magmalag/Rod-Custom-55mm-ITB-Telemetry/RU.README.md

# VRod-Custom-55.5mm-ITB-Telemetry
Deep modernization, custom 55mm throttle bodies, asymmetric intake calculation, and Python/Arduino telemetry for H-D V-Rod
##  О проекте (About the Project)
Комплексный проект по глубокой модернизации впускной системы двигателя H-D Revolution (1250cc). Включает в себя механическую обработку (Custom Hardware), расчет газодинамики (Engine Simulation) и разработку программно-аппаратного комплекса для сбора и анализа телеметрии.

**Цель:** Переход со штатных 53 мм дросселей на 55 мм с сохранением стабильного холостого хода и максимизацией КПД на 9000 RPM.

---

##  Механика и Железо (Hardware & CAD)
Штатные оси и дроссельные заслонки не выдерживают нагрузок при увеличении диаметра. Узел был спроектирован с нуля:

* **Корпуса:** Расточены до 55 мм.
* **Оси (Split Shaft):** Кастомная составная ось из нержавеющей стали (8 мм). Фиксация винтов выполнена методом развальцовки стальным шариком (авиационный стандарт) для предотвращения обрыва от вибраций V-Twin.
* **Заслонки (Butterflies):** Выточены из твердой автоматной латуни (ЛС59-1, 1.5 мм). 
* **Геометрия:** Смоделирован эллипс под углом 4.5°. В CAD-системе рассчитан и устранен критический зазор в 23 микрона (0.023 мм) возле оси, что обеспечило 100% герметичность при закрытом дросселе (IAC control stabilized).






---

##  Газодинамика (Engine Analyzer Pro)
Двигатель V-Rod имеет разнодлинный выхлоп Rinehart 2-1 (Front 72 см / Rear 85 см). Для компенсации наполнения цилиндров (Volumetric Efficiency) была рассчитана асимметричная впускная система:

* **Front Stack:** 12.7 см — компенсирует короткий выхлоп, создает инерционный наддув на 6500-7000 RPM.
* **Rear Stack:** 9.5 см — позволяет цилиндру дышать на 8500-9000 RPM.

Моделирование доказало, что на 2250 RPM потоки (CFM) уравновешиваются, что позволило провести идеальную механическую синхронизацию ITB.



---

##  Софт и Телеметрия (Data Engineering & Tuning)
Для настройки нестандартного железа была использована система **Daytona Twin Tec (Alpha-N)**.

* **Data Logging:** Написаны скрипты на Python для парсинга, фильтрации аппаратного шума и агрегации сырых логов.
* **Синхронизация:** Анализ `MAP Delta` подтвердил идеальную механическую сборку (разница на холостом ходу составила всего 0.17 in-Hg).




---

##  Результат
Полностью рабочая, откалиброванная система, превосходящая заводские аналоги по надежности (нержавеющая сталь + ЛС59-1) и аэродинамике. Идеальный холостой ход и ровная полка мощности до 9500 RPM.



---
