magmalag/Rod-Custom-55mm-ITB-Telemetry/Images/IMG_20260406_121022.jpg

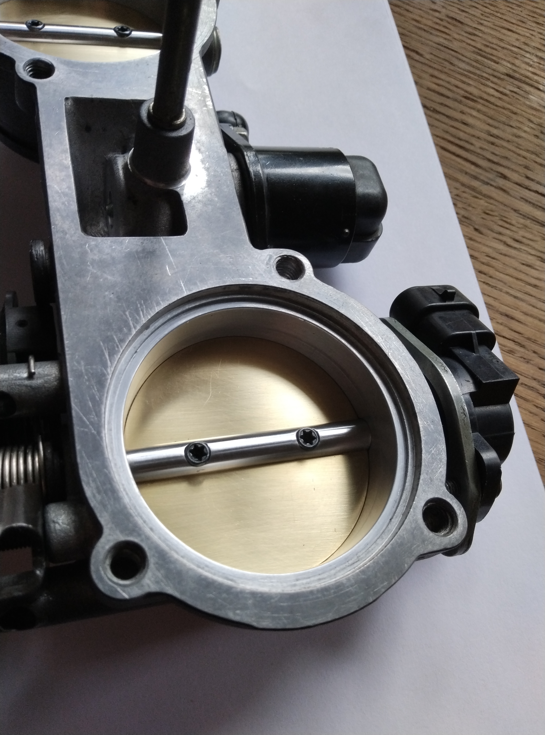
Images/IMG_20260406_121022.jpg
