magmalag/Rod-Custom-55mm-ITB-Telemetry/Images/IMG_20260425_112852.jpg

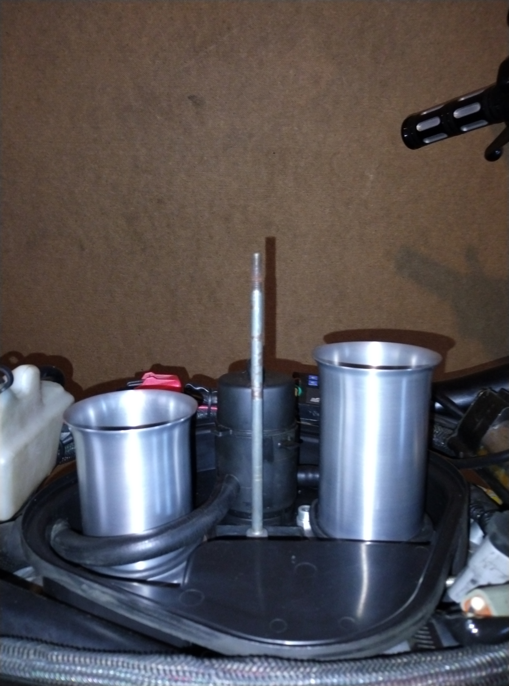
Images/IMG_20260425_112852.jpg
