magmalag/Rod-Custom-55mm-ITB-Telemetry/Images/IMG_20260425_112922.jpg

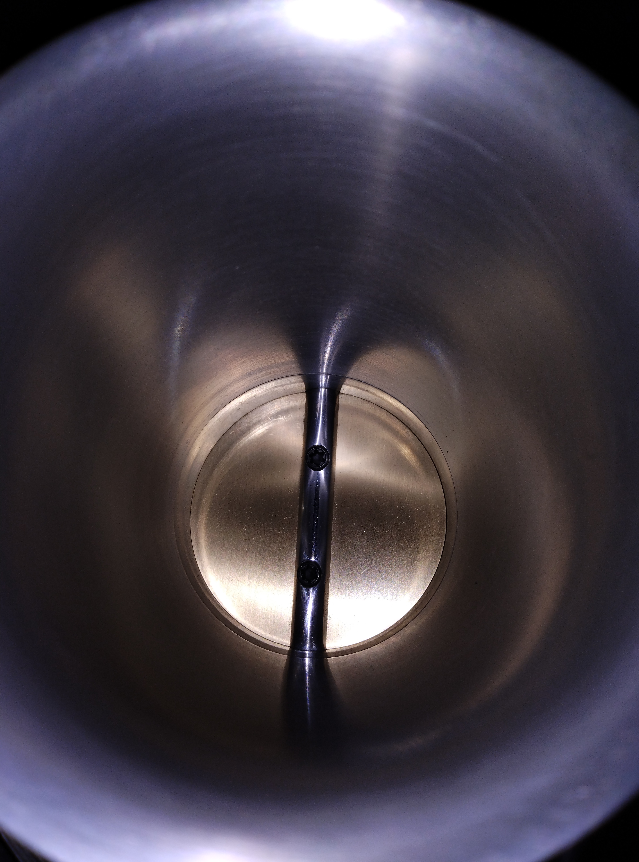
Images/IMG_20260425_112922.jpg
