magmalag/Rod-Custom-55mm-ITB-Telemetry/CAD_Model/Vrod throttle body 55.5mm.FCStd

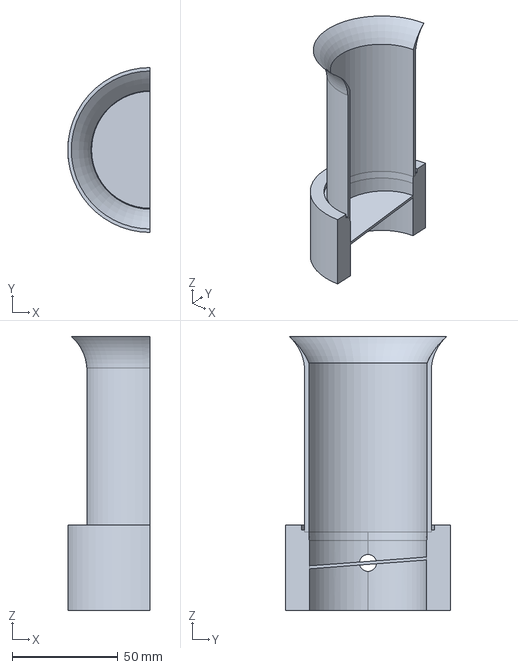
[picture p13: CAD file, 2026-04-25]
CAD_Model/Vrod throttle body 55.5mm.FCStd
39.0 x 78.0 x 129.5 mm
