magmalag/Rod-Custom-55mm-ITB-Telemetry/CAD_Model/Vrod throttle body base 53mm.FCStd

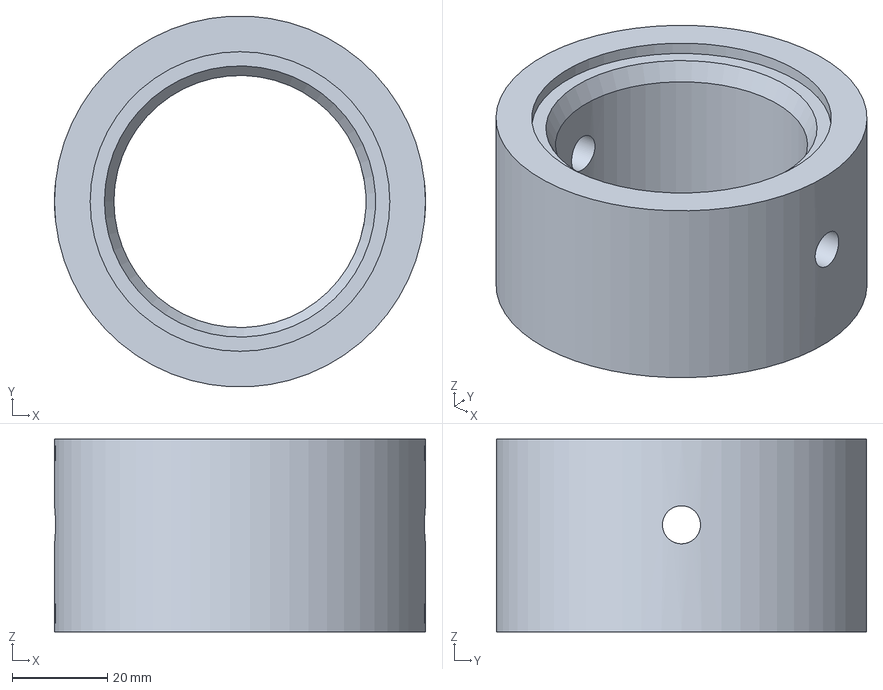
[picture p14: CAD file, 2026-04-25]
CAD_Model/Vrod throttle body base 53mm.FCStd
78.0 x 77.9 x 40.5 mm
