magmalag/Rod-Custom-55mm-ITB-Telemetry/CAD_Model/Throttle shaft part.FCStd

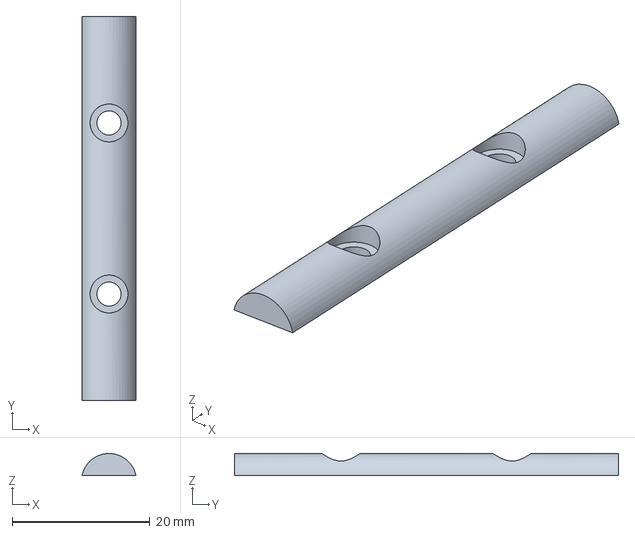
[picture p15: CAD file, 2026-04-25]
CAD_Model/Throttle shaft part.FCStd
7.84 x 55.8 x 3.20 mm
