magmalag/Rod-Custom-55mm-ITB-Telemetry/CAD_Model/Throttle shaft front.FCStd

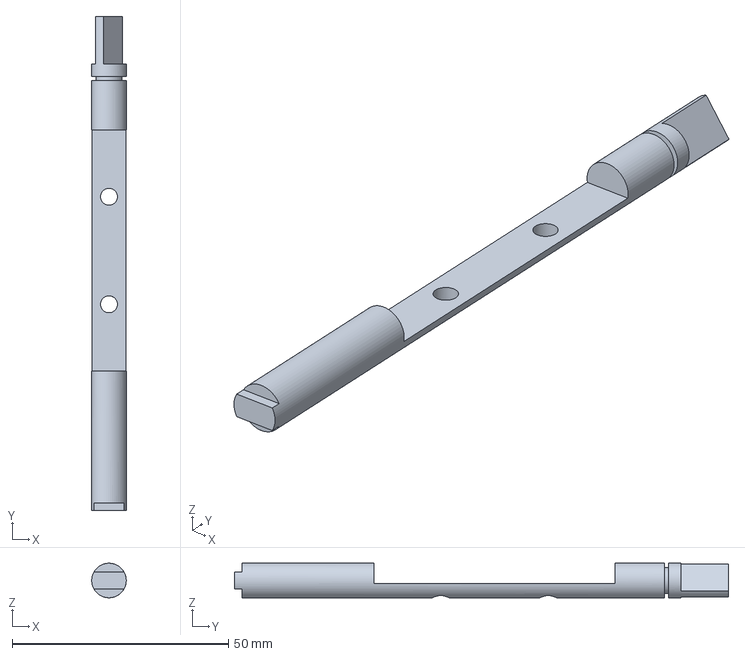
[picture p16: CAD file, 2026-04-25]
CAD_Model/Throttle shaft front.FCStd
8.00 x 114.2 x 8.00 mm
