magmalag/Rod-Custom-55mm-ITB-Telemetry/CAD_Model/Throttle shaft rear.FCStd

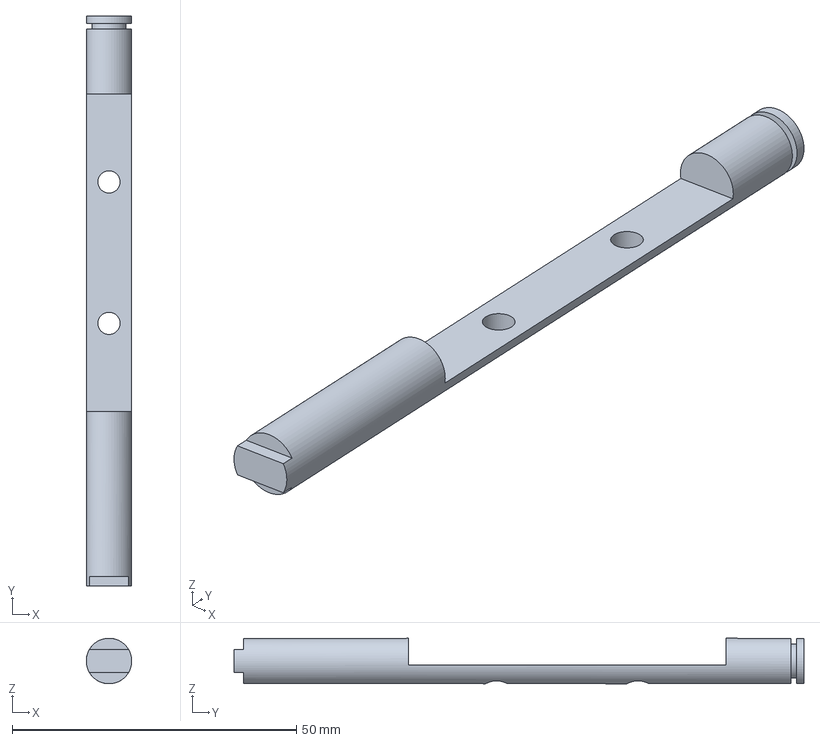
[picture p17: CAD file, 2026-04-25]
CAD_Model/Throttle shaft rear.FCStd
7.99 x 100.2 x 8.00 mm
