magmalag/Rod-Custom-55mm-ITB-Telemetry/(commit log)

2026-04-25 Rename Throttle shaft front.FCStd to CAD_Model/Throttle shaft front.FCStd
    [Throttle shaft front.FCStd]
2026-04-25 Rename Throttle shaft part.FCStd to CAD_Model/Throttle shaft part.FCStd
    [Throttle shaft part.FCStd]
2026-04-25 Rename Throttle shaft rear.FCStd to CAD_Model/Throttle shaft rear.FCStd
    [Throttle shaft rear.FCStd]
